YoussefSal/Exhausting-UAV/DBF.jpg

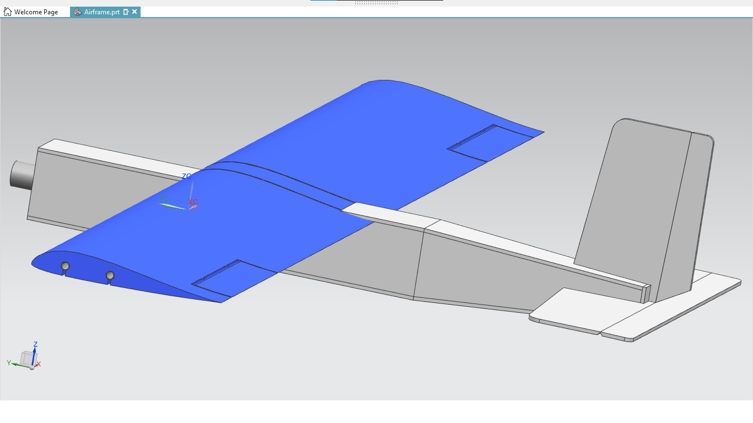
DBF.jpg
