YoussefSal/Exhausting-UAV/Report DBF-7 .pdf

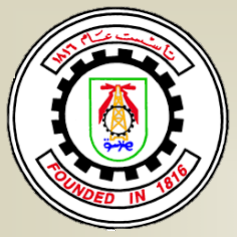
[picture p2: figure]
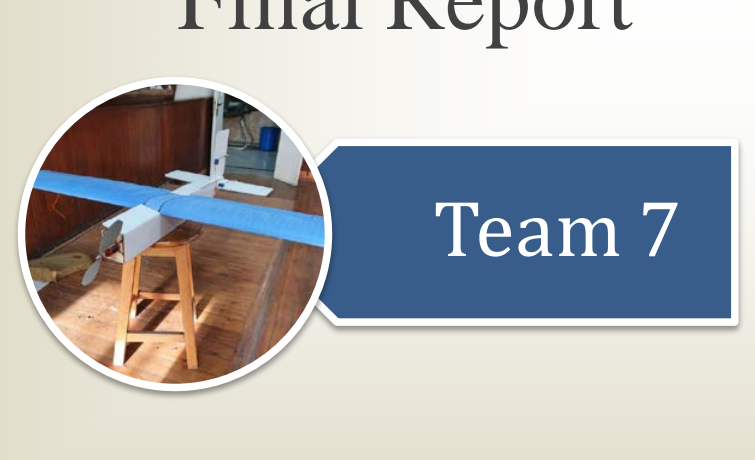
[picture p3: figure]
Team 7

Submitted on 3/10/2021

# DBF 2021

# Final Report

## Team Members

### Mohamed Ghanem Mohamed Salah

### Yousef Salah Mazen Hossam

### Moaaz Zaki

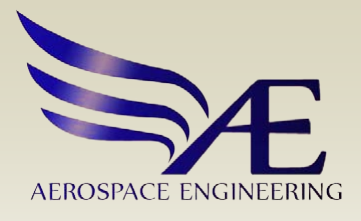
[picture p4: figure]

Team 7 | DBF2021

## Table of Contents

- Introduction | 2
- Preliminary Design | 2
- Detailed Design | 9
- Manufacturing | 15
- Management Summary | 17

## Introduction

Our plane is called DBF-7. A UAV airplane designed for a banner mission consistingof 3 stages: the first one is performing one lap with the banner on board, the second one is deploying the banner and completing two additional laps, and the third one is releasing the banner and doing a final lap before landing.
The plane has a conventional configuration which is a high wing with a conventional tail assembly, it best meets the requirements of the mission because it has better aerodynamics data, saves room for the banner, and also well distribution of weight.

## Preliminary Design

## Weight estimation

The first stage of preliminary design was estimating the weight of the aircraft using statistical data that was supplied by the UDC staff. A graphical model of useful weight against the maximum takeoff weight was built from the data and then used to estimate the maximum takeoff weight of our own aircraft.

# UUUUUUffuuuu WW iiggℎtt = WW ℎtt oo bbbb bbbb + WW ℎtt oo mm mm pp dd = 0.180 + 0.250 = 0.43 kkgg

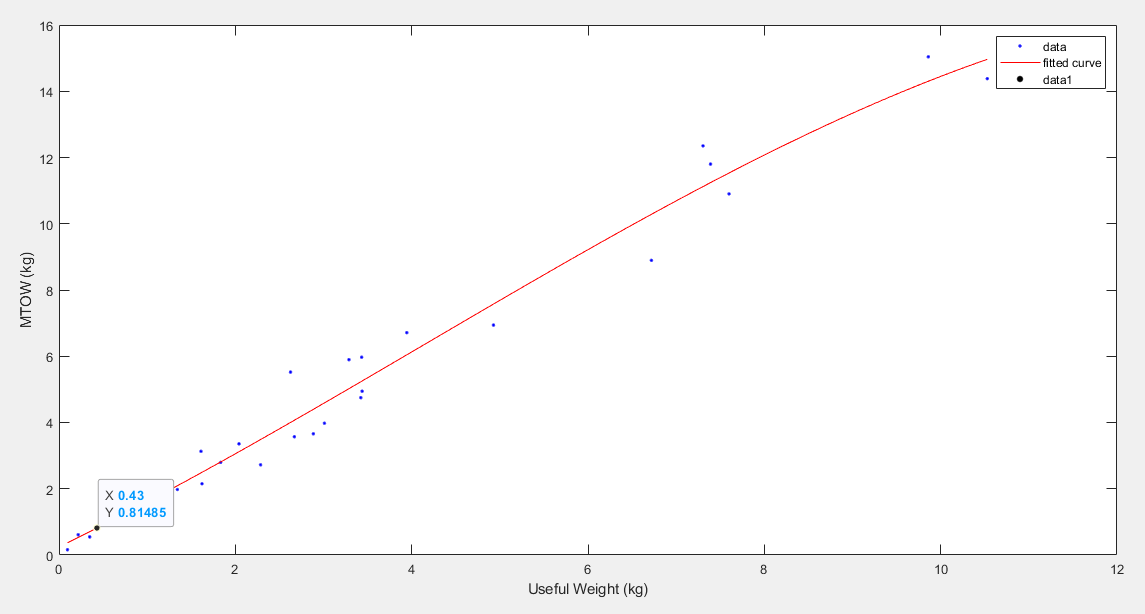
[picture p5: figure]

Fitted curve fromweight estimation data

Using the model, we have estimated our MTOW (maximum takeoff weight) to be 0.814 kg, however, that was not the weight we used in the latter calculations as it was soon apparent that the data was inconsistent after review by the UDC staff, and the MTOW was later increased to 1.5 kg as advised by said staff.

## Constraint graphs

A number of design constraints related to the mission requirements had to be made and used to calculate important parameters of the aircraft. The variables used to model the constraints were either assumed or given by the mission requirements. The following is a list of the variables used in the model.

- Stall speed = 7 m/s | • Cd0 = 0.02 | • Throwing speed = 5 m/s
- Cruise speed = 20 m/s | • AR = 7 | • CdT/O = 0.03
- CLmax = 1.4 | • T/O speed = 7.7 m/s | • T/O distance = 2 m
- Weight = 1.5 kg | • Thrust = 13.23 N

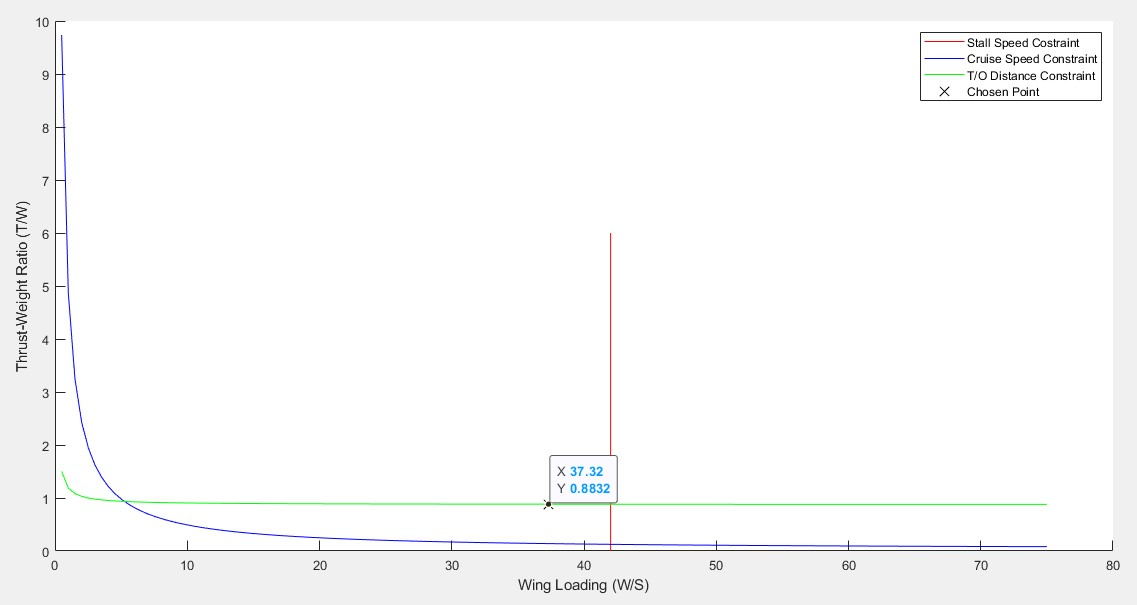
[picture p6: figure]

Constraint Graphs

A point chosen on the graph was used to choose the airfoil and calculate a number of crucial parameters as follows.

## Airfoil Selection

Using the data retrieved from the constraint graphs we have narrowed down the search for a fitting airfoil to 3, namely the Clark Y, N-81, and NACA 2412. After tedious research and consideration, our team settled on the N-81 airfoil owing to its high lift and superior stability.
N-81 Airfoil Specs:
- Maximum thickness = 12.99%
- Maximum thickness position = 22.52%
- Maximum camber = 3.52%
- Maximum camber position = 22.52%
- Weight = 1.529 kg | • AR =5.5 | • CL2D = 1.34
- Stall speed = 7 m/s | • Wing span = 1.485 m | • CL3D = 1.244
- Wing area = 0.401 m² | • Mean chord = 0.27 m | • Cd0 = 0.02

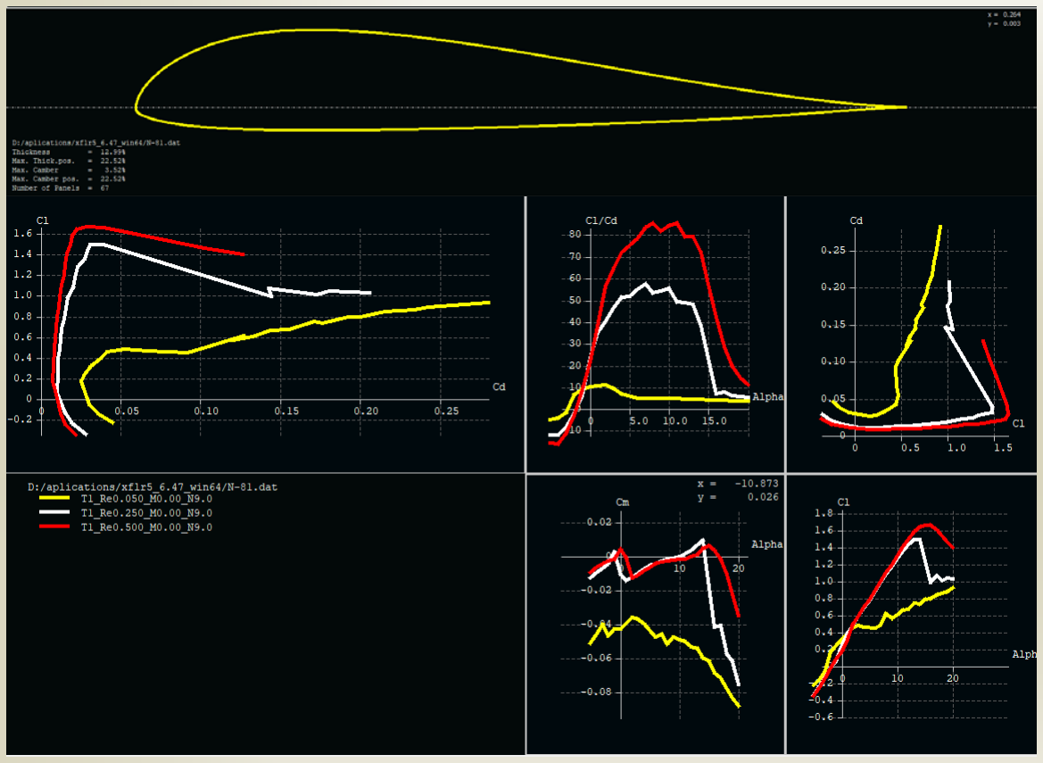
[picture p7: figure]

N-81 airfoil XFLR5 analysis

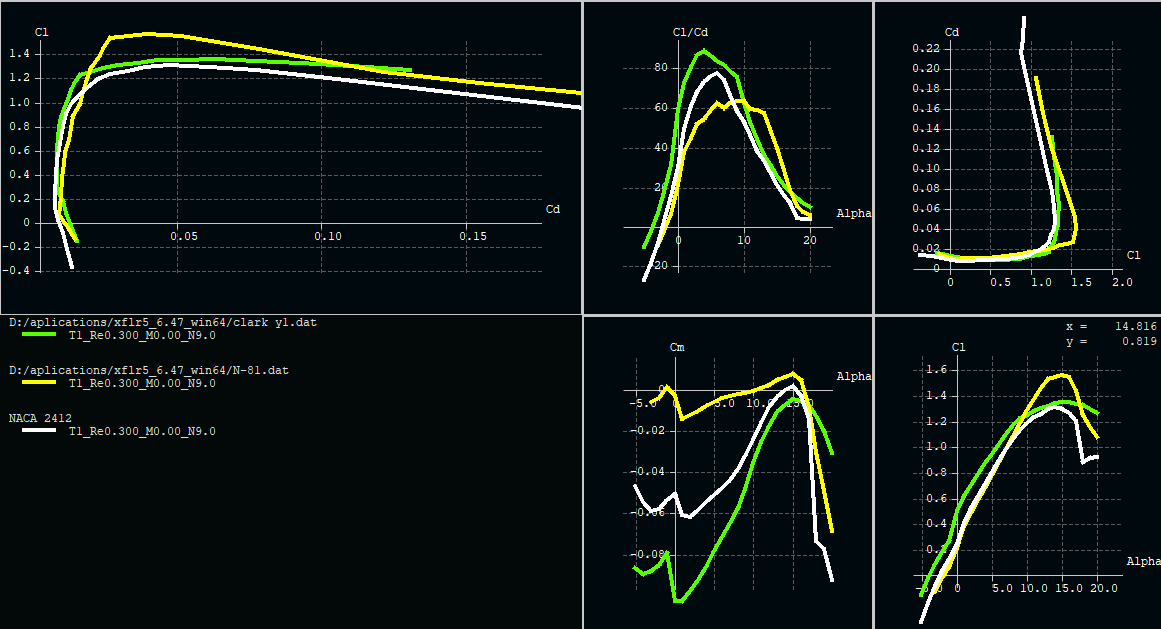
[picture p8: figure]

## Configuration selection

We have a number of designs combining different wing and tail configurations to reach reasonable stability and performance using trial & error.
We created three configurations: 1. Low wing, T-tail 2. Canard 3.Conventional, high wing.
They nearly have moderate graphs and stability, but we faced other issues which will be discussed in detail.

### Low wing, T-tail configuration

Our first design was a low wing with a froward sweep and a T-tail configuration. We assumed it might be the most suitable configuration for the mission as the flow vortices created by the stabilizers would have a reduced effect on the banner while being towed behind the
aircraft. | However, | after | the
feedback session from the UDC
staff, we were informed that the tail

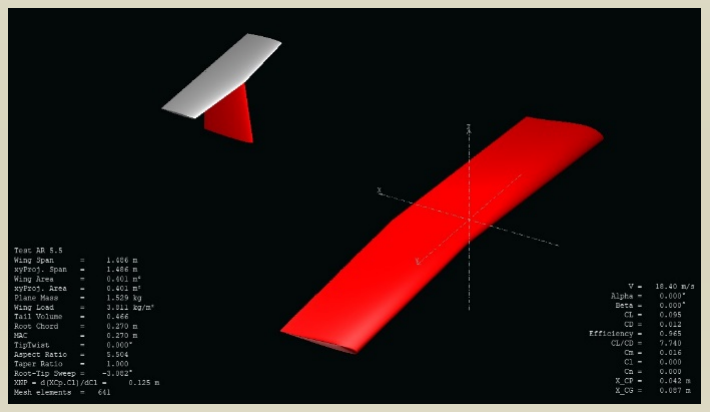
[picture p9: figure]

configuration has little effect on the banner towing as opposed to what we first thought. Additionally, the T-tail would have been challenging when it comes to manufacturing, and the forward sweep would have been redundant, if not

Comparing Clark-Y, N-81, and NACA 2412 airfoil data

T-tail configuration

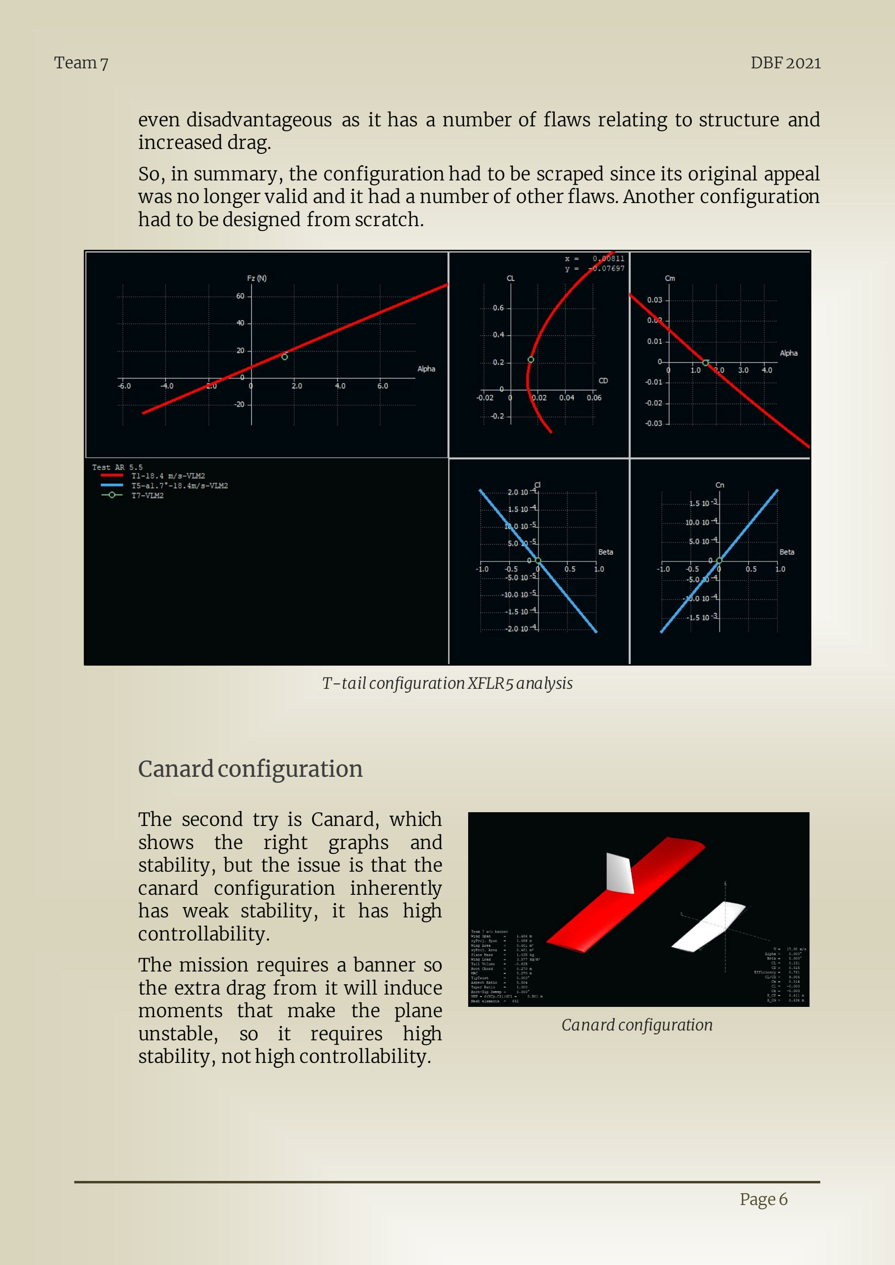
[picture p10: page 7]

even disadvantageous as it has a number of flaws relating to structure and increased drag.
So, in summary, the configuration had to be scraped since its original appeal was no longer valid and it had a number of other flaws. Another configuration had to be designed from scratch.

### Canard configuration

The second try is Canard, which shows the right graphs and stability, but the issue is that the canard configuration inherently has weak stability, it has high controllability.
The mission requires a banner so the extra drag from it will induce moments that make the plane unstable, so it requires high stability, not high controllability.

T-tail configurationXFLR5 analysis

Canard configuration

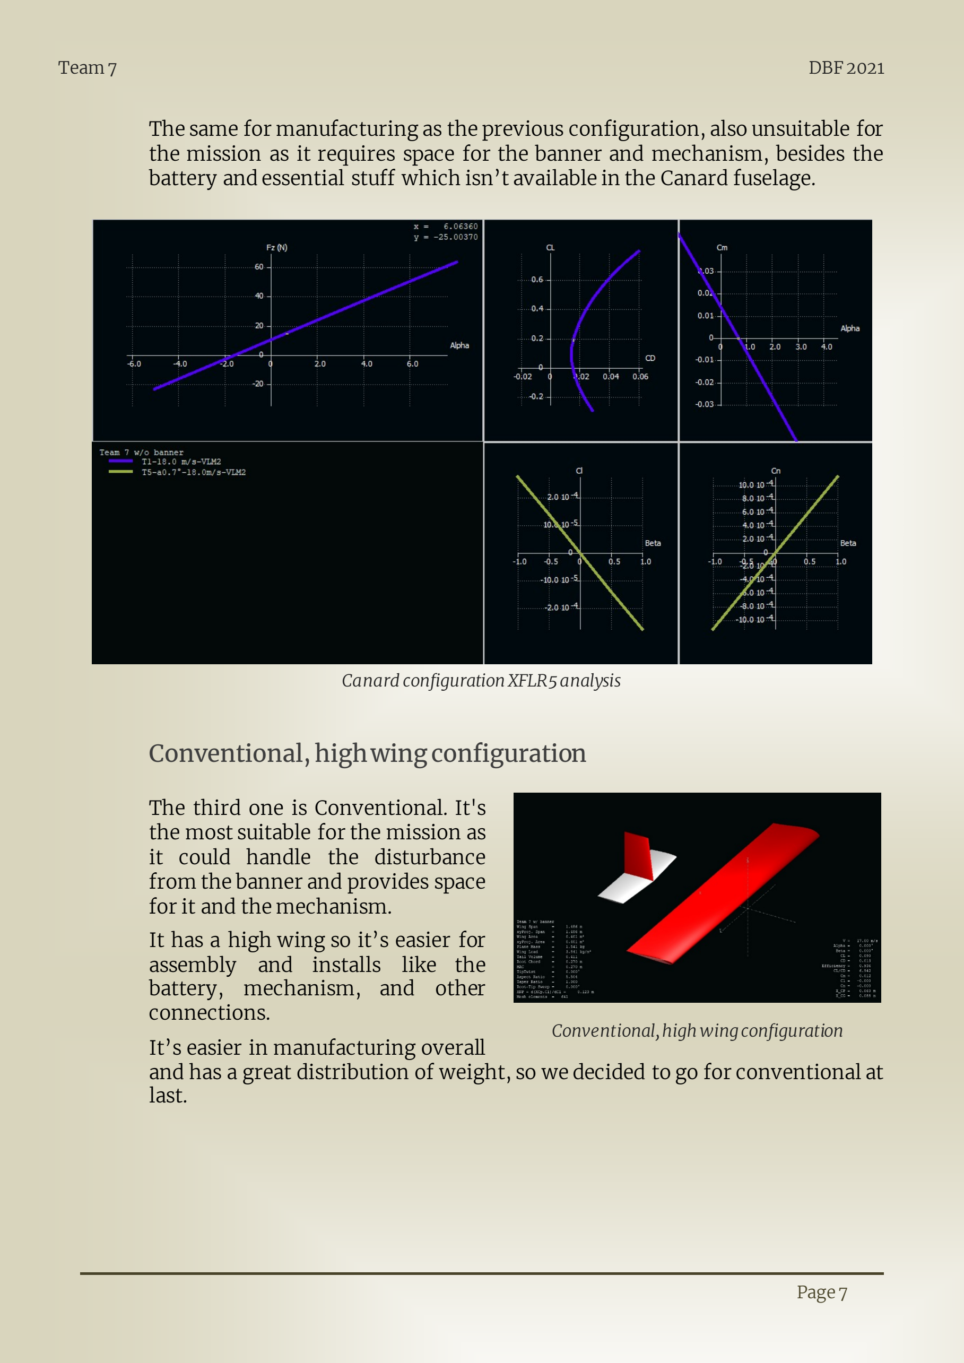
[picture p11: page 8]

The same for manufacturing as the previous configuration, also unsuitable for the mission as it requires space for the banner and mechanism, besides the battery and essential stuff which isn’t available in the Canard fuselage.

### Conventional, high wing configuration

The third one is Conventional. It's
the most suitable for the mission as
it could handle the disturbance
from the banner and provides space for it and the mechanism.
It has a high wing so it’s easier for assembly and installs like the battery, mechanism, and other
connections.
It’s easier in manufacturing overall
and has a great distribution of weight, so we decided to go for conventional at last.

Canard configuration XFLR5 analysis

Conventional, high wing configuration

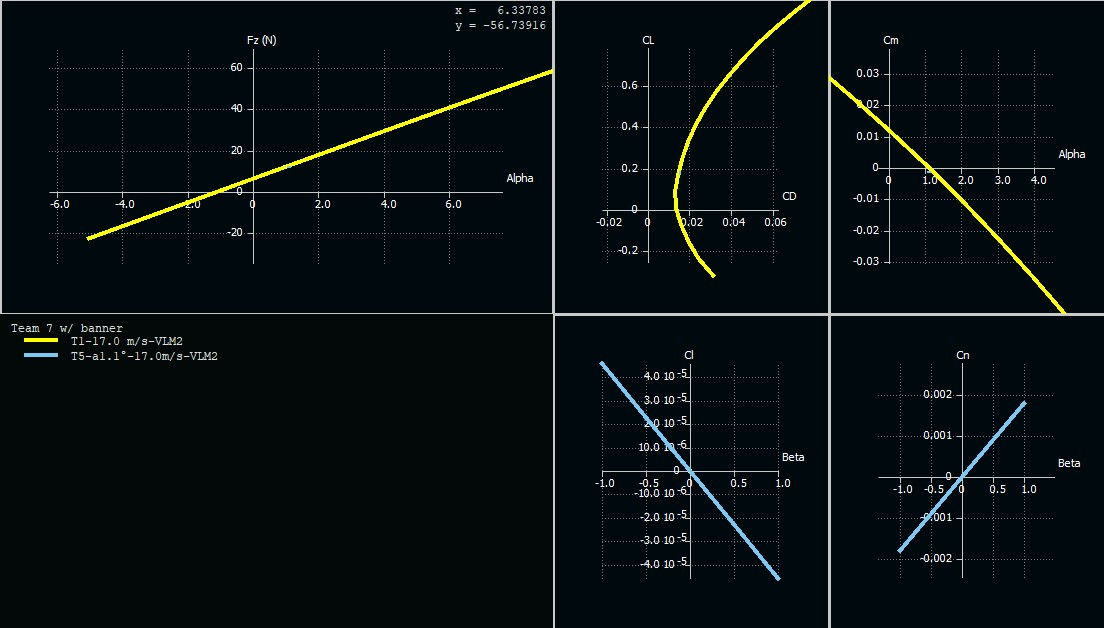
[picture p12: figure]

Conventional, high wing configuration XFLR5 analysis

## Detailed Design

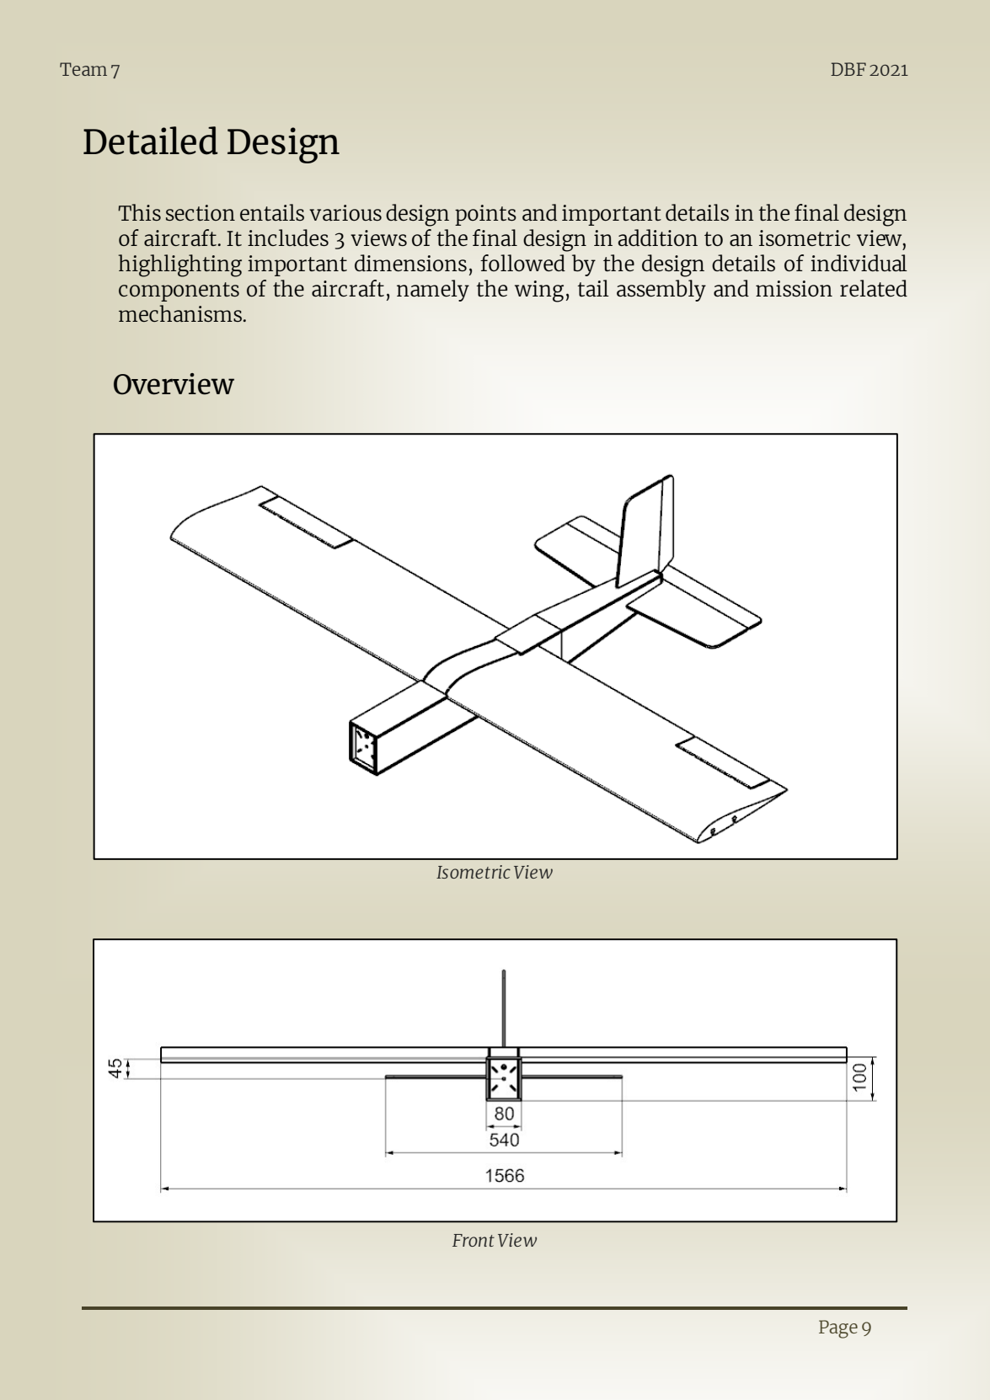
[picture p13: page 10]

This section entails various design points and important details in the final design of aircraft. It includes 3 views of the final design in addition to an isometric view, highlighting important dimensions, followed by the design details of individual components of the aircraft, namely the wing, tail assembly and mission related mechanisms.

## Overview

Isometric View

Front View

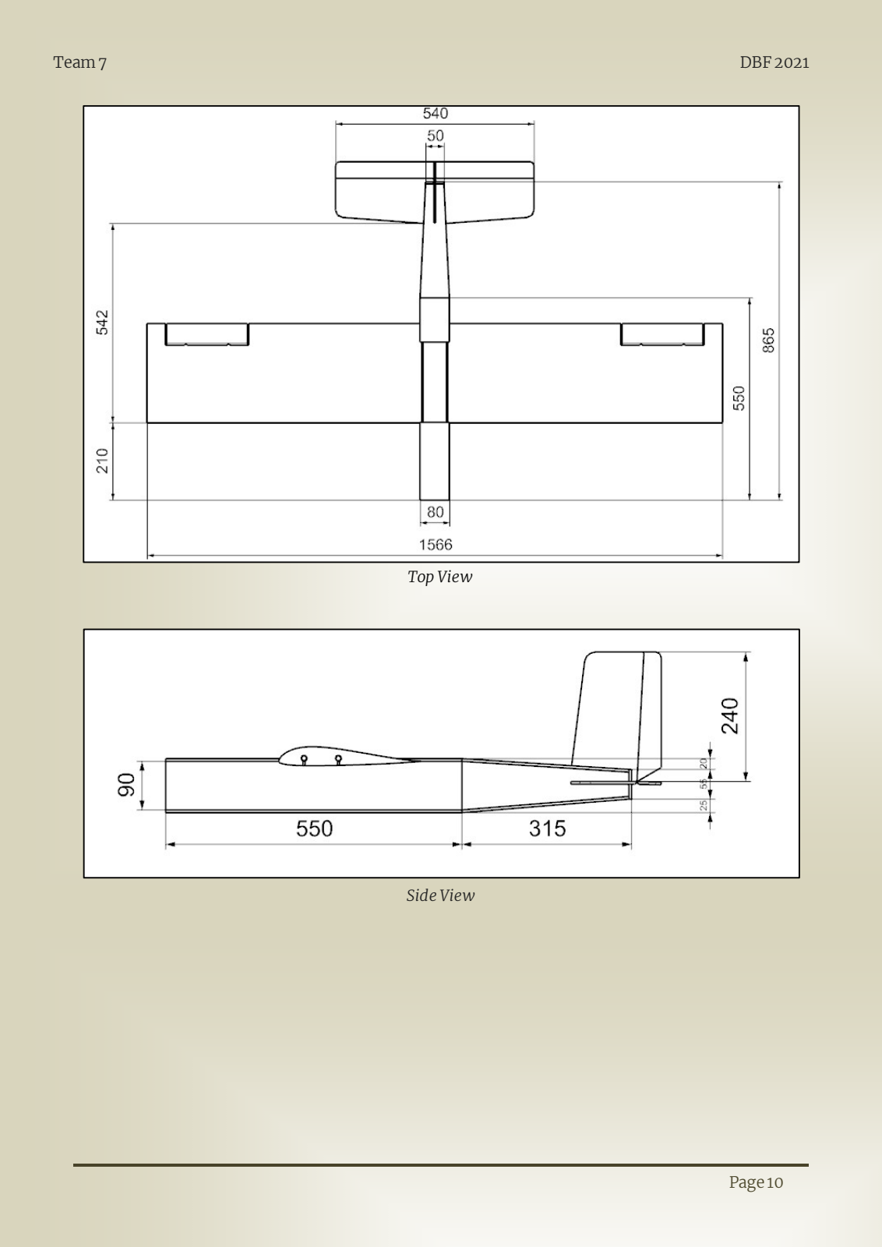
[picture p14: page 11]

Top View

Side View

## Weight Balance Table

The following table was created based on the actual weights and component placements after manufacturing.

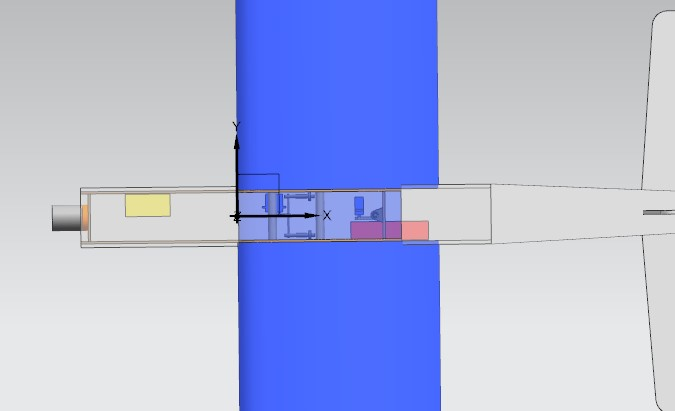
[picture p15: figure]

Item | Mass (g) | CgX (mm) | CgY (mm)
Fuselage + Wing + Tail Assembly + Mechanisms Motor + Propeller Esc Receiver Battery Extra Weight (coin) | 820 163 -1 190 -217 0 27 -106.5 18.5 17 -106.5 18.5 177 162 -23 9 100 450
Total | 1240 94.6 0

Datum used fordistances in the weight balancetable

## Wing

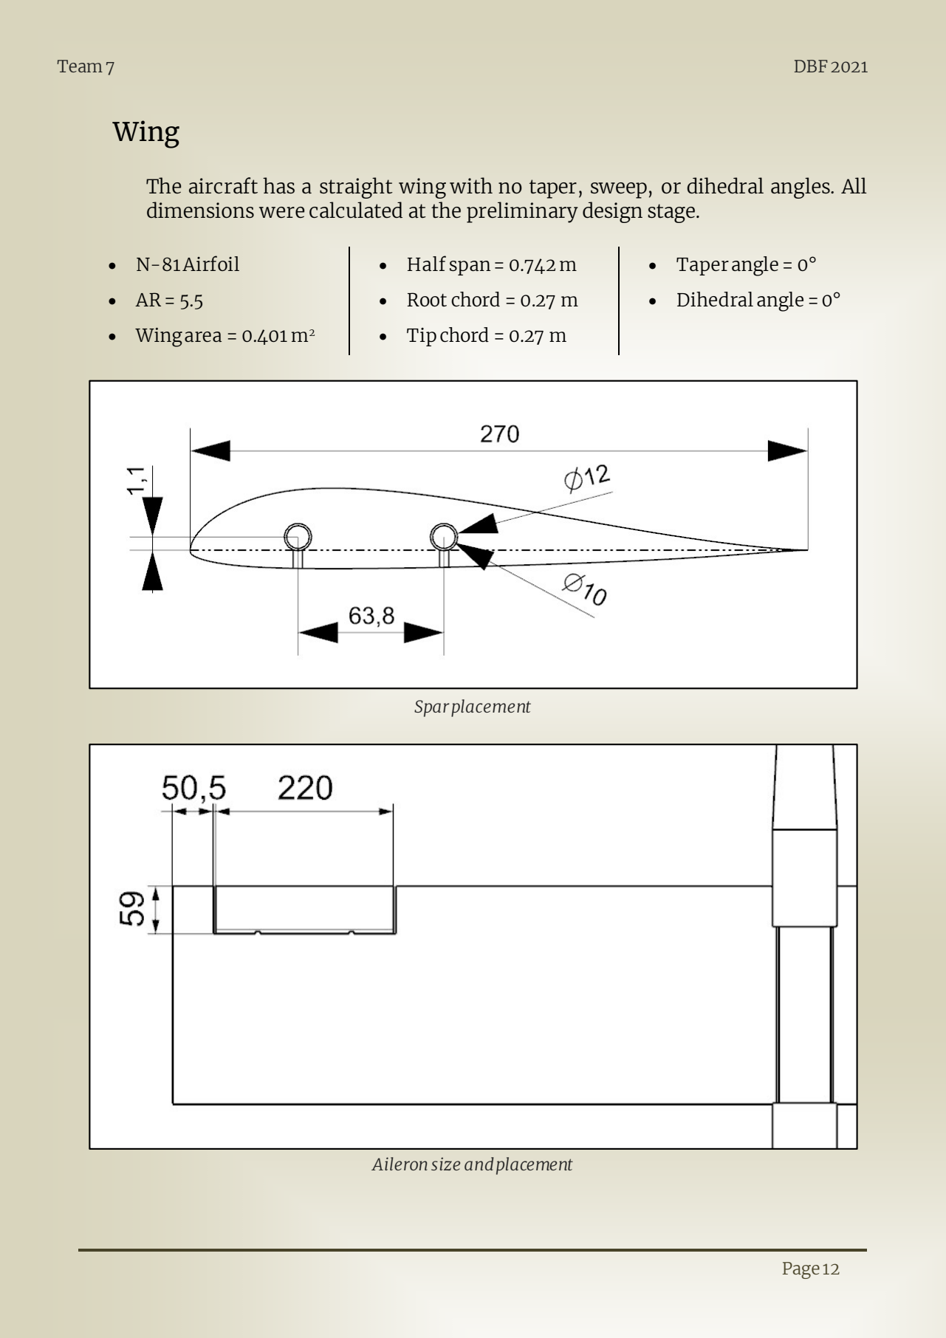
[picture p16: page 13]

The aircraft has a straight wing with no taper, sweep, or dihedral angles. All dimensions were calculated at the preliminary design stage.

- N-81Airfoil | • Half span = 0.742 m | • Taper angle = 0°
- AR= 5.5 | • Root chord = 0.27 m | • Dihedral angle = 0°
- Wing area = 0.401 m² | • Tip chord = 0.27 m

Spar placement

Aileron size and placement

## Tail Assembly

### Horizontal Tail Data

### Vertical Tail Data

## Mission Mechanisms

Two mechanisms have been created to carry out the mission objectives. One mechanism is for unfolding the banner so it can be towed behind the aircraft in full display, and another to drop the banner completely for the final lap of flight.

### Release Mechanism

The release mechanism is first in
the position shown. Two threads hold the banner underneath the aircraft; these threads are fixated in 2 positions each underneath the aircraft while the middle of the threads is wrapped around a spoke.
- Flat Plate | • Half span = 0.27 m | • Sweep angle = 3.18°
- Root chord = 0.17 m | • Tail area = 0.09 m² | • Tilt angle =0 °
- Tip chord = 0.15 m | • Elevator span = 100%
- Elevator root chord = 0.045 m | Elevator tip chord = 0.045 m
- Flat Plate | • Span = 0.24 m | • Sweep angle = 5.36°
- Root chord = 0.17 m | • Tail area = 0.04m² | • Tilt angle =0 °
- Tip chord = 0.14 m | • Rudderspan = 100%
- Rudder root chord = 0.045 m | Rudder tip chord = 0.032 m

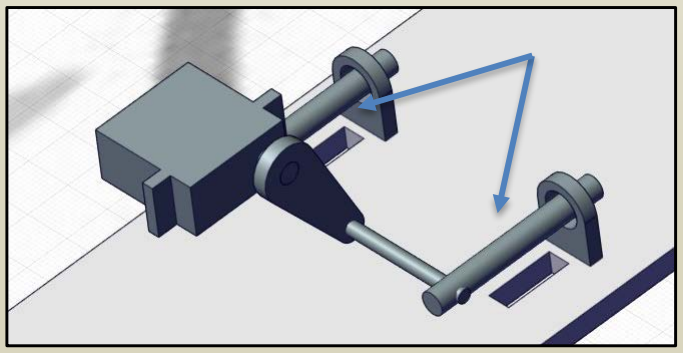
[picture p17: figure]

Initial position of the release mechanism, the two arrows point to the spokes

As the mechanism is activated, the spokes move backward, allowing the threads to slide off and out through the oppenings in the underbelly of the fuselage.

### DropMechanism

The drop mechanism follows a similar idea to the release mechanism. A fishing line is used to tow the banner behind the aircraft; one end of the line is allowed to slide over the spoke shown in the figure, and then it is led through an opening in the back of the aircraft to finally connect to the banner.

As the mechanism is activated, the spoke is pulled downwards allowing the thread to slide off and effectively drop the banner from the aircraft.

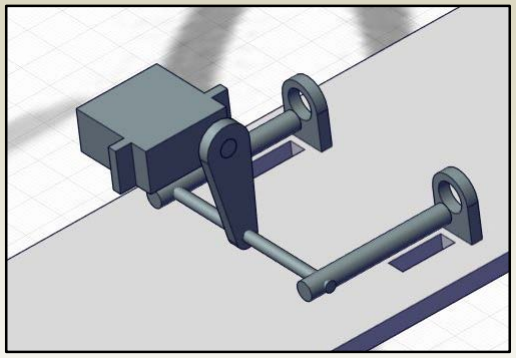
[picture p18: figure]

Final position of the release mechanism

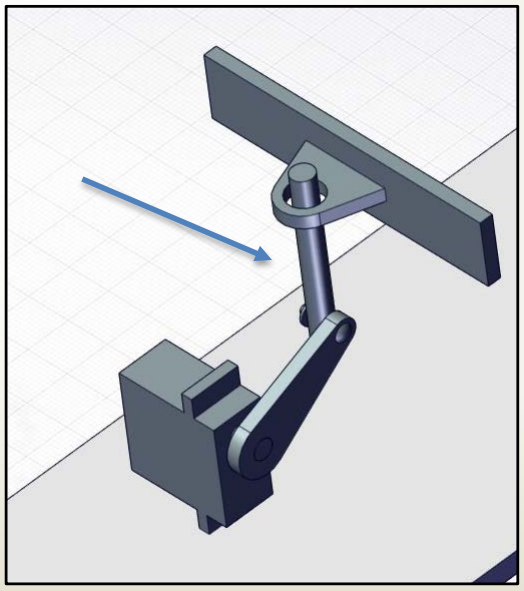
[picture p19: figure]

Initial position of the drop mechanism, the arrow points to the spoke

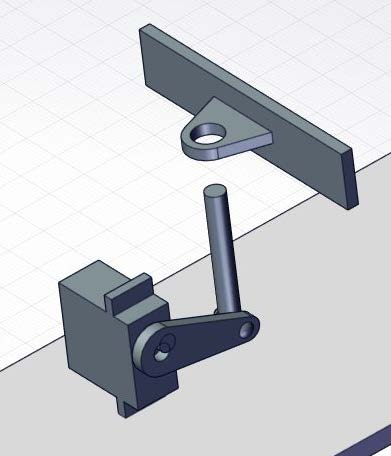
[picture p20: figure]

Final position of the drop mechanism

## Manufacturing

## Materials

- 2 sheets of white foam 5 mm thickness
- One sheet of EVA foam 50 mm thickness
- Balsa wood
- 2 bars of aluminum of 10 mm diameter
- Hot glue and super glue
- White foam for main parts fuselage and tail.
- Blue foam for the wing.
- Plywood for reinforcement, motor mount, and mechanism.
- 2 aluminum rods are used as spars for the wing.

## Machines Used

- Laser cutting machine.
- Hot-wire cutting machine for airfoils.

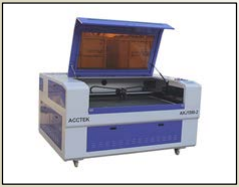
[picture p21: figure]

## Process

### Fuselage

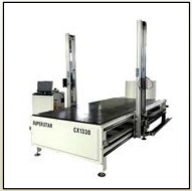
[picture p22: figure]

First, we cut the fuselage on a sheet of foam by the laser cutting machine as one piece with half-cut between its parts, then stick it with hot glue, then we cut the supports on a sheet of plywood using the laser machine then the white foam is installed on it using hot glue as well.

Co2 laser cutting machine | Hot wire cutting machine foam

### T-tail

We cut the tail configuration on a sheet of foam using a laser cutting machine.

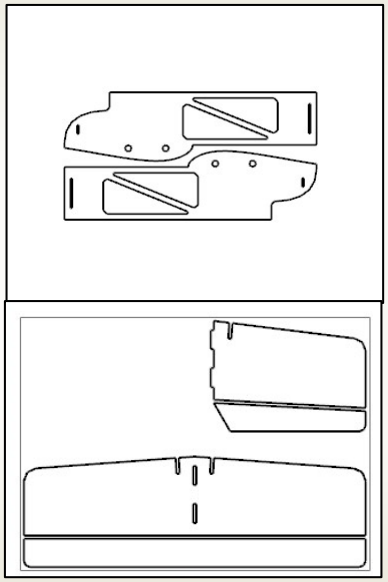
[picture p23: figure]
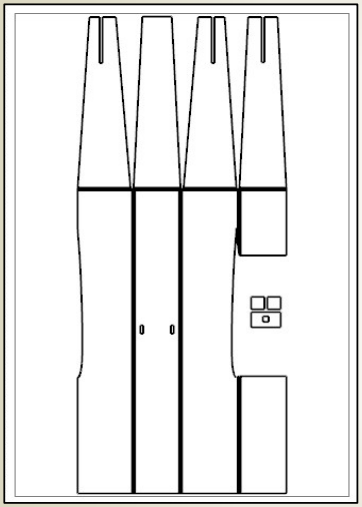
[picture p24: figure]

Sketches used in the DXF files for the laser cutter

## Management Summary

The table below shows as follows: Each member has a main task where they focused on and a side task where they participated in.

Member | Main Task | Side Task
Mohamed Salah | XFLR5, wing CAD | CAD, mechanism design, Manufacturing
Youssef Salah | Report,Tail CAD | XFLR5, Manufacturing
Mohamed Ghanem | Fuselage & assembly CAD, mechanism design | XFLR5,Report, Manufacturing
Mazen Hosam | CAD Demo, Report | XFLR5, Manufacturing
Moaaz Zaki | Manufacturing | -
*All participants shared in design and decisions making.

The following chart shows
how much time each task has
taken in percent of the whole
time which is nearly 90 days starting from July.

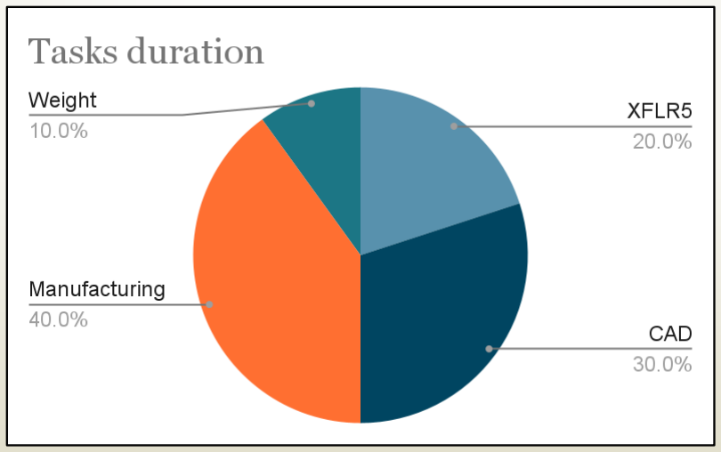
[picture p25: figure]

Task time distribution

Special thanks to Eng. Mohamed El-Masry and Eng. Mona Ahmed who have been with us every step of the way
