YoussefSal/Exhausting-UAV/DBF XFLR.jpg

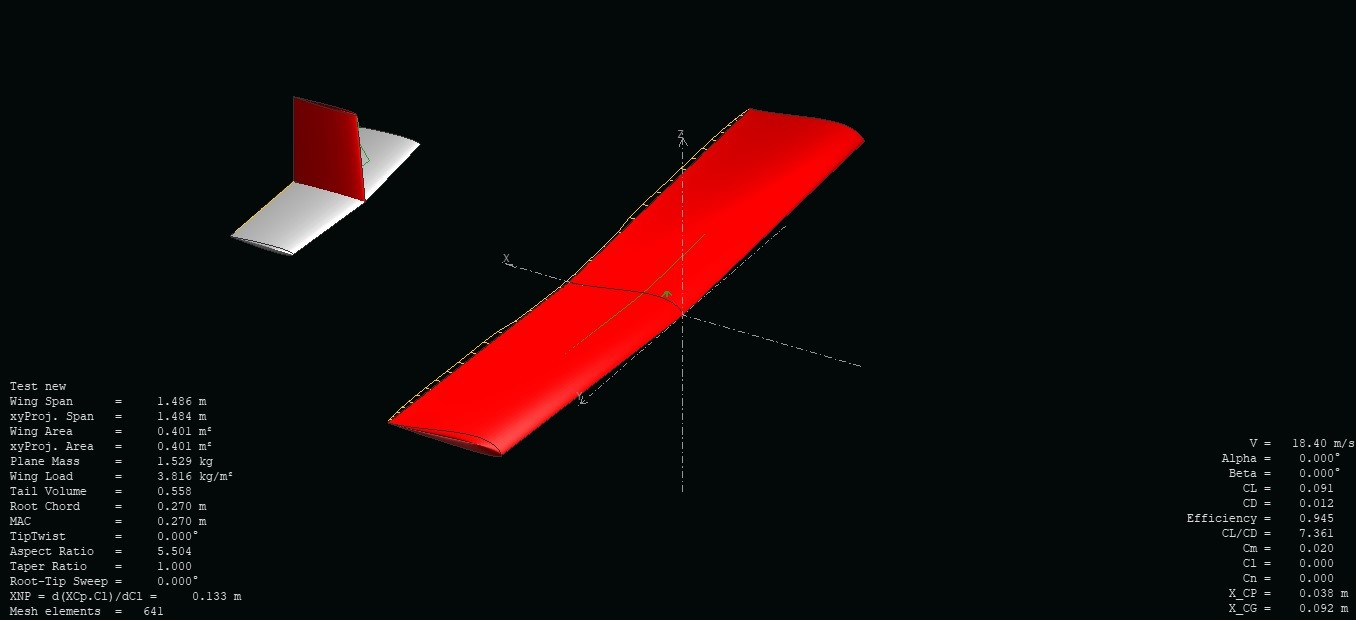
DBF XFLR.jpg
