YoussefSal/Exhausting-UAV/XFLR charts.jpg

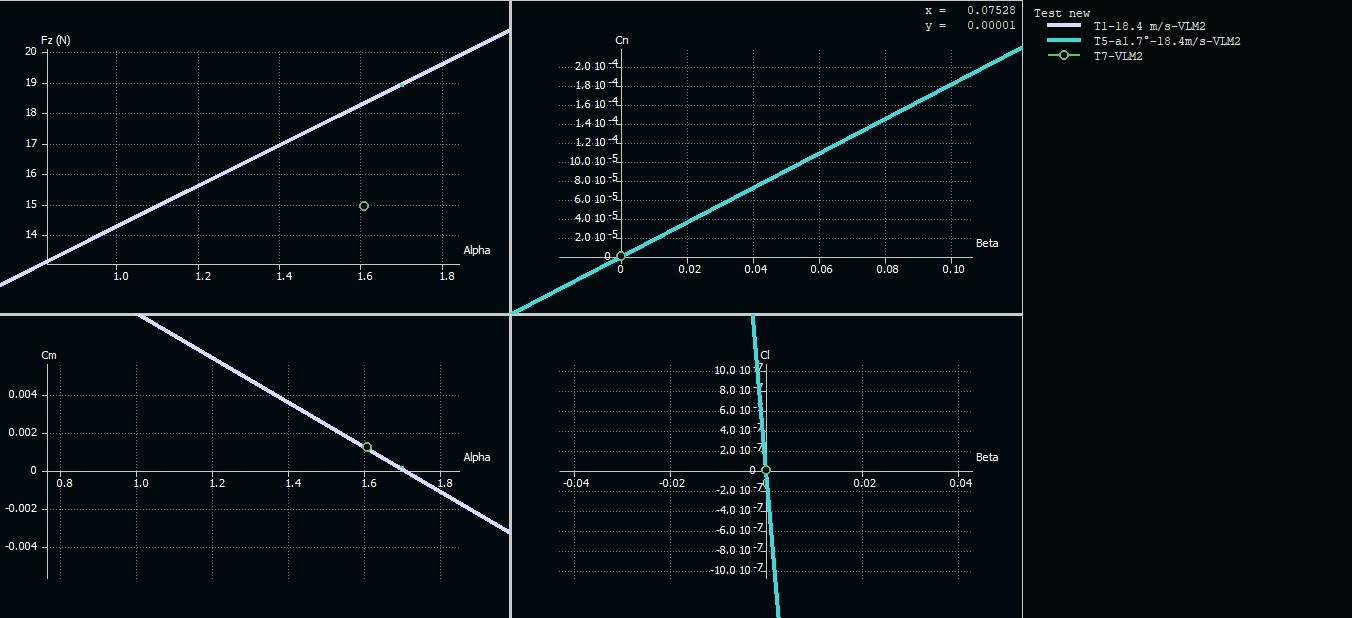
XFLR charts.jpg
