YoussefSal/Exhausting-UAV/CAD/DXF/FUSELAGE!!!!.DXF

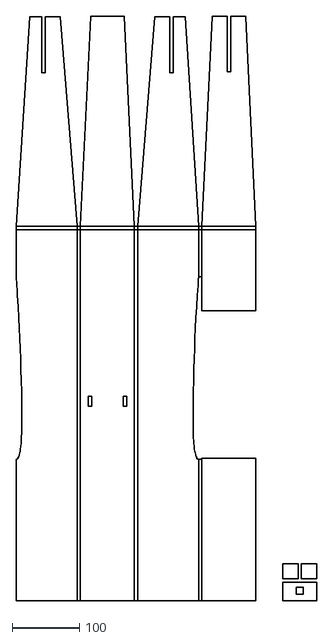
[picture p28: CAD file, 2022-07-31]
CAD/DXF/FUSELAGE!!!!.DXF
445.0 x 866.4
