YoussefSal/Exhausting-UAV/CAD/DXF/White Foam 1 FINAL.dxf

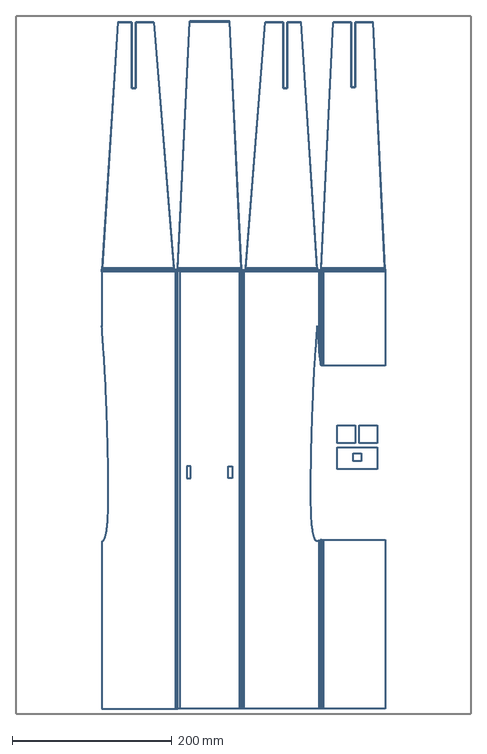
[picture p29: CAD file, 2022-07-31]
CAD/DXF/White Foam 1 FINAL.dxf
569.6 x 874.4 mm
