YoussefSal/Exhausting-UAV/CAD/DXF/Plywood 2.dxf

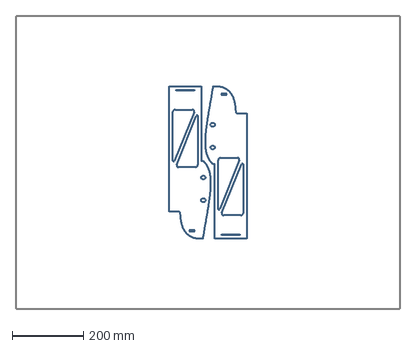
[picture p30: CAD file, 2022-07-31]
CAD/DXF/Plywood 2.dxf
1077.6 x 823.6 mm
