YoussefSal/Exhausting-UAV/CAD/DXF/mechanism 11111.dxf

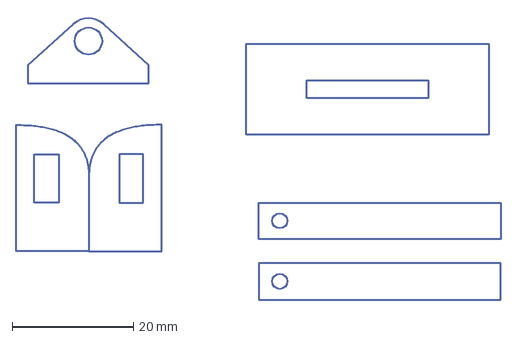
[picture p31: CAD file, 2022-07-31]
CAD/DXF/mechanism 11111.dxf
80.0 x 46.8 mm
