YoussefSal/Exhausting-UAV/CAD/DXF/yes.dxf

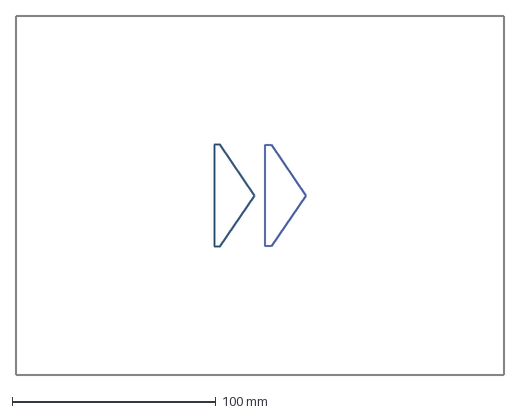
[picture p32: CAD file, 2022-07-31]
CAD/DXF/yes.dxf
239.4 x 175.9 mm
