YoussefSal/Exhausting-UAV/CAD/DXF/White Foam 1_B.dxf

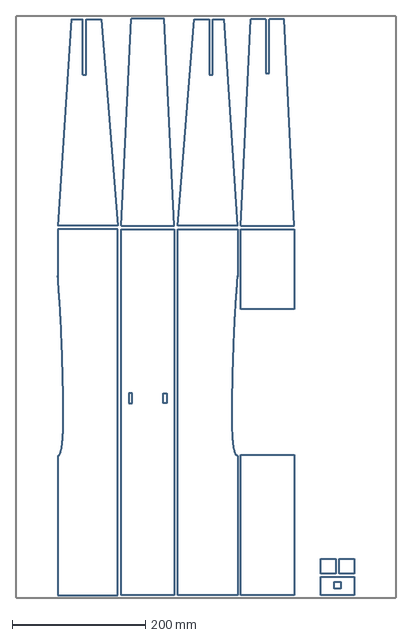
[picture p33: CAD file, 2022-07-31]
CAD/DXF/White Foam 1_B.dxf
569.6 x 874.4 mm
