YoussefSal/Exhausting-UAV/CAD/DXF/Plywood.dxf

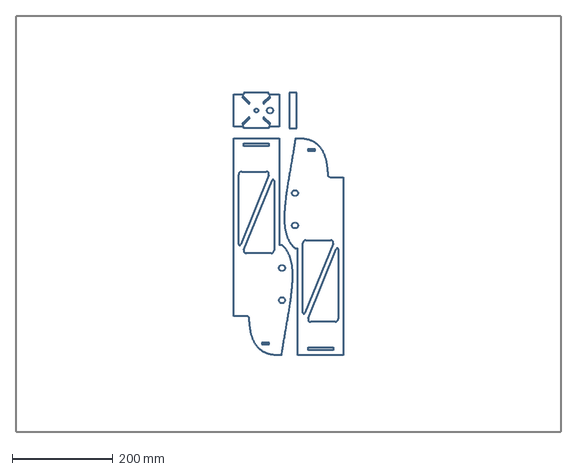
[picture p34: CAD file, 2022-07-31]
CAD/DXF/Plywood.dxf
1077.6 x 823.6 mm
