YoussefSal/Exhausting-UAV/CAD/DXF/White Foam 1_A.dxf

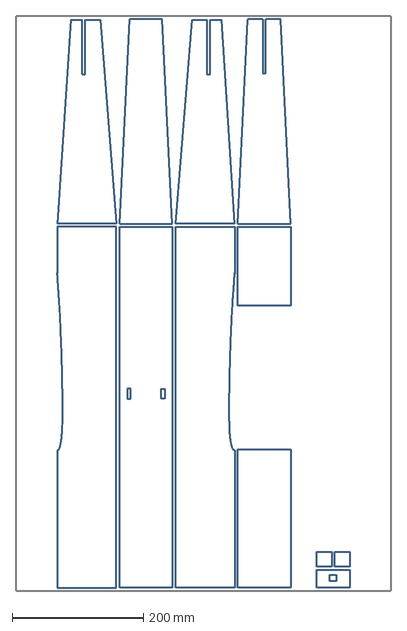
[picture p35: CAD file, 2022-07-31]
CAD/DXF/White Foam 1_A.dxf
569.6 x 874.4 mm
