YoussefSal/Exhausting-UAV/CAD/DXF/White Foam 2.dxf

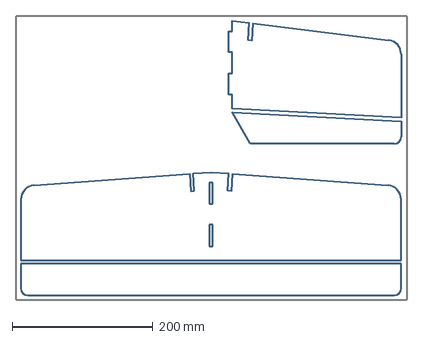
[picture p36: CAD file, 2022-07-31]
CAD/DXF/White Foam 2.dxf
554.0 x 402.7 mm
