YoussefSal/Exhausting-UAV/CAD/DXF/White Foam 1_obsolete.dxf

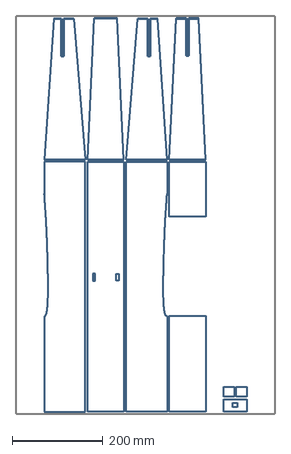
[picture p37: CAD file, 2022-07-31, an earlier design]
CAD/DXF/White Foam 1_obsolete.dxf
569.6 x 874.4 mm
