YoussefSal/Exhausting-UAV/(list of files, cad)

Other CAD files:
CAD/Airframe.prt
CAD/Battery.prt
CAD/DXF/Plywood Parts/Motor Mount.prt
CAD/DXF/Plywood Parts/Side Support.prt
CAD/DXF/Plywood Parts/Support.prt
CAD/DXF/Plywood.prt
CAD/DXF/White Foam 1.prt
CAD/DXF/White Foam 2.prt
CAD/DXF/White Foam Parts/Aft Cover.prt
CAD/DXF/White Foam Parts/Floor (aft).prt
CAD/DXF/White Foam Parts/Floor (front).prt
CAD/DXF/White Foam Parts/Htail.prt
CAD/DXF/White Foam Parts/Roof (aft).prt
CAD/DXF/White Foam Parts/Roof (front).prt
CAD/DXF/White Foam Parts/Rudder.prt
CAD/DXF/White Foam Parts/Side (front).prt
CAD/DXF/White Foam Parts/Side L (aft).prt
CAD/DXF/White Foam Parts/Side L (front).prt
CAD/DXF/White Foam Parts/Side R (aft).prt
CAD/DXF/White Foam Parts/Side R (front).prt
CAD/DXF/White Foam Parts/Vtail.prt
CAD/DXF/White Foam Parts/elevator.prt
CAD/DXF/White_Foam_1.prt
CAD/DXF/holder.prt
CAD/DXF/mechanism 11111.prt
CAD/DXF/yes.prt
CAD/Drop Mechanism/Drop Mechanism.prt
CAD/Drop Mechanism/Pin.prt
CAD/Drop Mechanism/Rocker.prt
CAD/Drop Mechanism/Support.prt
CAD/Drop Mechanism/Thingie 2.prt
CAD/ESC.prt
CAD/Fuselage/Aft Cover.prt
CAD/Fuselage/Floor (aft).prt
CAD/Fuselage/Floor (front).prt
CAD/Fuselage/Fuselage.prt
CAD/Fuselage/Motor Mount.prt
CAD/Fuselage/Roof (aft).prt
CAD/Fuselage/Roof (front).prt
CAD/Fuselage/Side (front).prt
CAD/Fuselage/Side L (aft).prt
CAD/Fuselage/Side R (aft).prt
CAD/Fuselage/Side Support.prt
CAD/Motor.prt
CAD/Release Mechanism/Hole.prt
CAD/Release Mechanism/Release Mechanism.prt
CAD/Release Mechanism/Rocker.prt
CAD/Release Mechanism/Rod.prt
CAD/Servo.prt
CAD/Tail/Htail.prt
CAD/Tail/Rudder.prt
CAD/Tail/Tail.prt
CAD/Tail/Vtail.prt
CAD/Tail/elevator.prt
CAD/Thingie.prt
CAD/Wing/L Wing.prt
CAD/Wing/R Wing.prt
CAD/Wing/Spars.prt
CAD/Wing/Wing Roof.prt
CAD/Wing/Wing.prt
